Bardreamaster/Chasis/README.md

# Robot Control Board

**Images**
