Bardreamaster/Chasis/Codes/img/003_vscode_open_folder.png

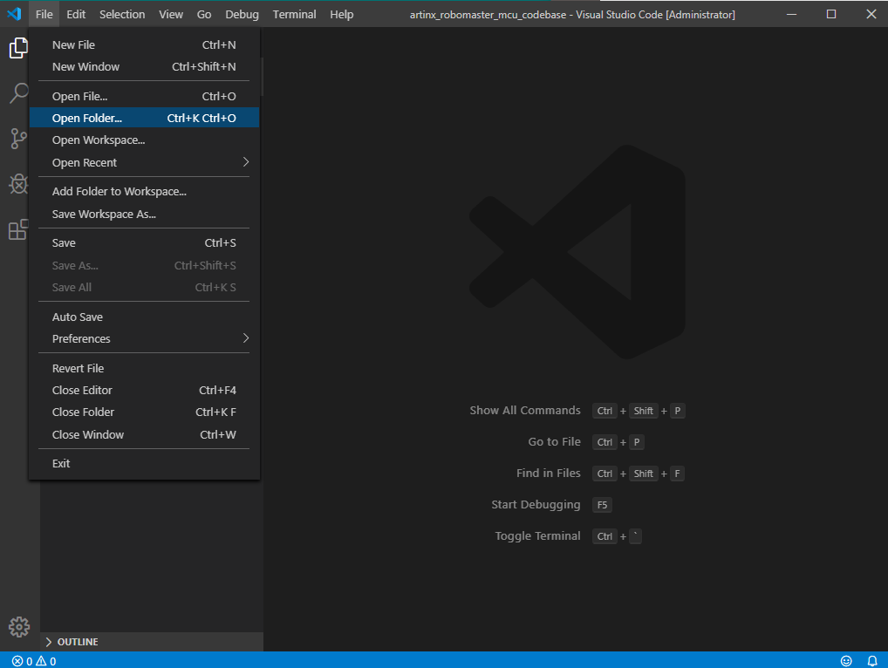
Codes/img/003_vscode_open_folder.png
