Bardreamaster/Chasis/Codes/img/004_vscode_open_folder_2.png

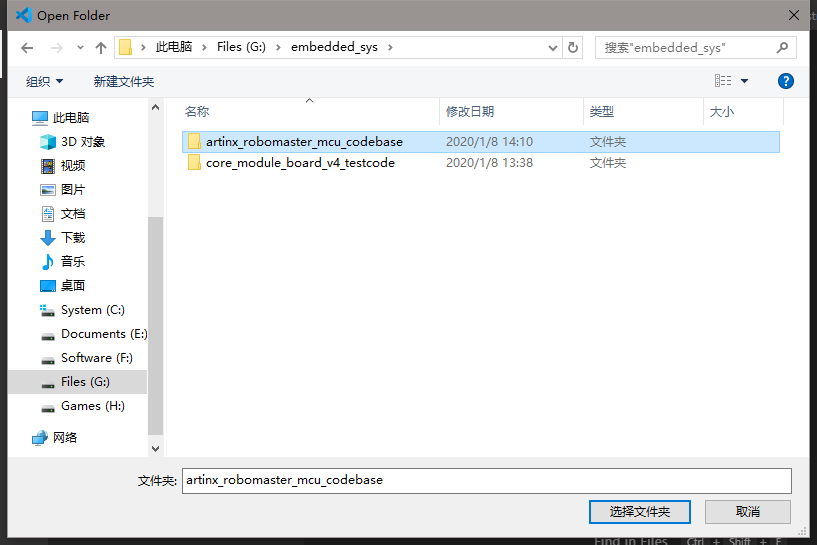
Codes/img/004_vscode_open_folder_2.png
