Bardreamaster/Chasis/Codes/img/013_clone_path.png

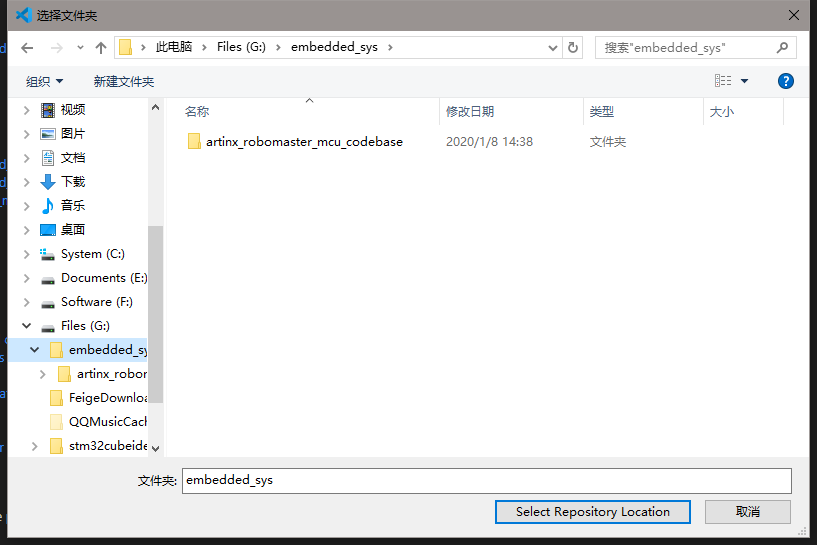
Codes/img/013_clone_path.png
