Bardreamaster/Chasis/Codes/img/015_includepath.png

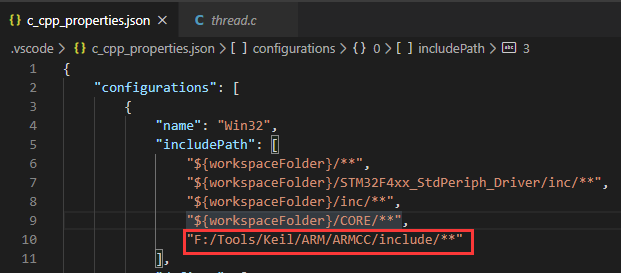
Codes/img/015_includepath.png
