Bardreamaster/Chasis/Schematic/CUT/Chasis1.2B1.png

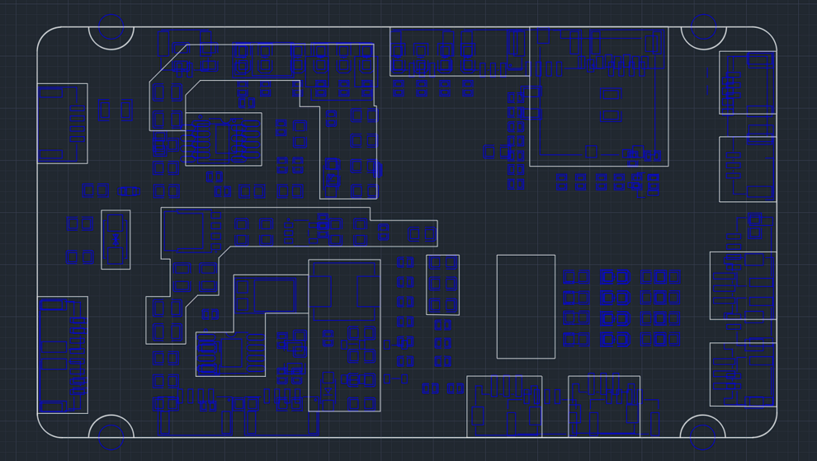
Schematic/CUT/Chasis1.2B1.png
