Bardreamaster/Chasis/Schematic/CUT/Chasis1.2B2.png

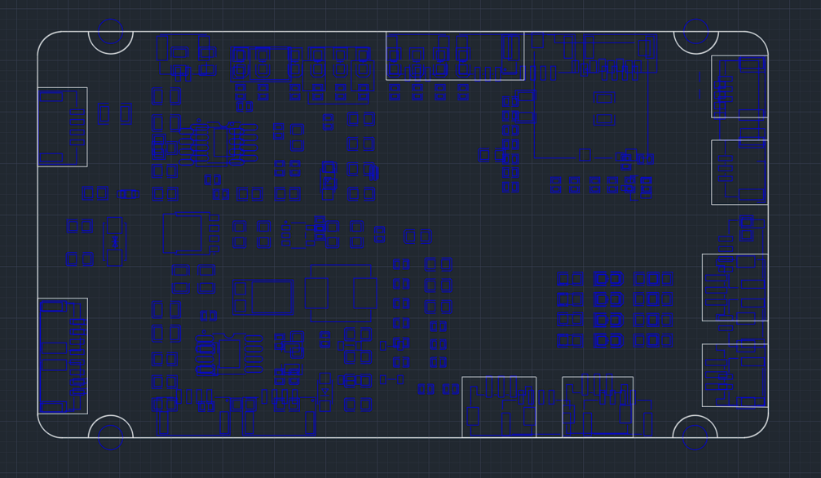
Schematic/CUT/Chasis1.2B2.png
