Bardreamaster/Chasis/Schematic/CUT/Chasis1.2T1.png

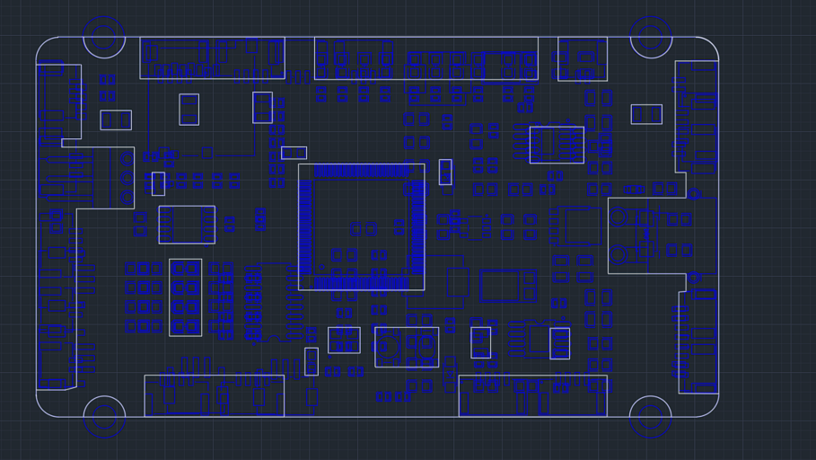
Schematic/CUT/Chasis1.2T1.png
