Bardreamaster/Chasis/Schematic/CUT/Chasis1.2T2.png

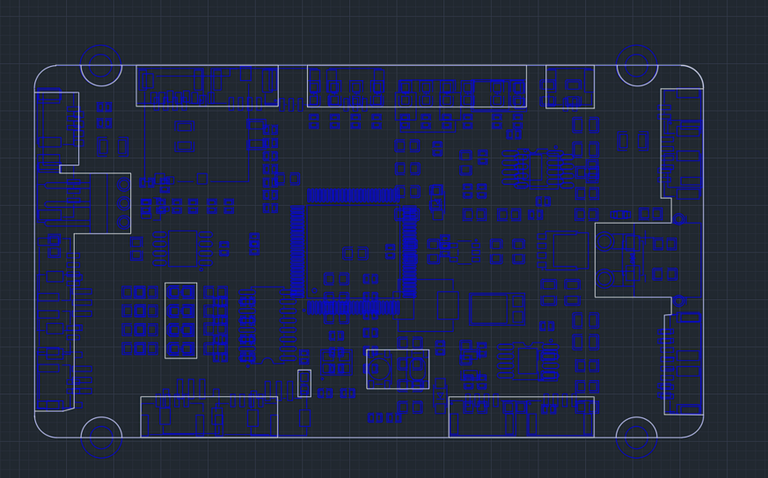
Schematic/CUT/Chasis1.2T2.png
