Bardreamaster/Chasis/Schematic/BOM_Chasis1.21_2020-05-11_00-41-37.csv

ID | Name | Designator | Footprint | Quantity | Manufacturer Part | Manufacturer | Supplier | Supplier Part | LCSC Assembly
1 | 22 | R66,R63,R67,R61,R57,R60 | R0402 | 6 | 0402WGF220JTCE | UniOhm | LCSC | C25092 | Yes
2 | SKRPADE010 | SW2 | KEY-SMD_4P-L4.2-W3.2-P2.20-LS4.6 | 1 | SKRPADE010 | ALPS | LCSC | C127488
3 | MF-NSMF050-2 | U9,U8,U2,U12,U7,U11 | FUSE-1206 | 6 | MF-NSMF050-2 | BOURNS | LCSC | C75464 | Yes
4 | 10uF | C12 | C0603 | 1 | CL10A106KP8NNNC | SAMSUNG | LCSC | C19702 | Yes
5 | 100 | R9,R16 | R0402 | 2 | AC0402FR-07100RL | YAGEO | LCSC | C144808
6 | molexP4卧 | CN1 | SMD-10.15X4.8-4P | 1 | 532610471 | MOLEX | LCSC | C127368
7 | 100k | R22 | R0603 | 1
8 | 33R | R23 | R0603 | 1
9 | X1251WVS-02HF-LPSW | CN11,CN12 | CONN-SMD_2P-V-P1.25-L_X1251WVS-02HF-LPSW | 2 | X1251WVS-02HF-LPSW | XKB Enterprise | LCSC | C388714
10 | 10K | R50,R49,R48,R69,R6,R3,R4,R2,R1,R65,R59,R55,R53,R52,R51 | R0402 | 15 | 0402WGF1002TCE | UniOhm | LCSC | C25744 | Yes
11 | 40.2K | R8,R15 | R0603 | 2 | 0603WAF4022T5E | UniOhm | LCSC | C12447 | Yes
12 | 4.7nF | C43,C30 | C0402 | 2 | 0402B472K500NT | FH | LCSC | C1538 | Yes
13 | X1251WRS-08HF-LPSW | CN26 | CONN-SMD_8P-H-P1.25-L_X1251WRS-08HF-LPSW | 1 | X1251WRS-08HF-LPSW | XKB Enterprise | LCSC | C388713
14 | 120 | R24,R32 | R0603 | 2 | CR0402FF1200G | LIZ | LCSC | C100218
15 | 68K | R13,R14,R20,R21 | R0603 | 4 | 0603WAF6802T5E | UniOhm | LCSC | C23231 | Yes
16 | PSMN1R5-30YLC,115 | Q1 | SOT-669_L4.9-W4.0-P1.27-LS6.0-BR | 1 | PSMN1R5-30YLC,115 | Nexperia | LCSC | C427523
17 | 18pF | C13,C14 | C0201 | 2 | GRM0335C1H180JA01D | MuRata | LCSC | C85892
18 | ORH-G36G | LED2,LED4,LED1,LED3,LED6,LED7,LED8,LED9,LED11,LED5 | LED0603-R-RD | 10 | ORH-G36G | Orient | LCSC | C205443 | Yes
19 | 100pF | C37,C24 | C0603 | 2 | CGA3E2C0G1H101JT0Y0N | TDK | LCSC | C76709
20 | 2.2uF | C15,C16 | C0603 | 2 | CL10A225KO8NNNC | SAMSUNG | LCSC | C23630 | Yes
21 | 12MHz | X1 | OSC-SMD_4P-L3.2-W2.5-BL | 1 | SMD-3225_4P12M12pf10ppm | TAE | LCSC | C133337 | Yes
22 | LP5907MFX-2.5/NOPB | U5 | SOT-23-5_L3.0-W1.7-P0.95-LS2.8-BL | 1 | LP5907MFX-2.5/NOPB | TI | LCSC | C165132 | Yes
23 | 6.8uH | L3,L2 | IND-SMD_L7.0-W6.6 | 2 | FXL0630-6R8-M | cjiang | LCSC | C167221
24 | SMAJ26CA-13-F | D5 | SMA_L4.4-W2.6-LS5.0-BI | 1 | SMAJ26CA-13-F | DIODES | LCSC | C134976 | Yes
25 | 10nf | C44 | C0603 | 1
26 | 19-217/R6C-AL1M2VY/3T | LED14,LED12,LED15,LED13,LED10 | LED0603-R-RD | 5 | 19-217/R6C-AL1M2VY/3T | EVERLIGHT | LCSC | C72044 | Yes
27 | 4.7K | R35,R37 | R0402 | 2 | RC-02W4701FT | Guangdong Fenghua Advanced Tech | LCSC | C304616
28 | 1K | R26,R28,R36,R38,R34,R33,R31,R30,R29,R68,R64,R27,R58,R54,R25 | R0402 | 15 | 0402WGF1001TCE | UniOhm | LCSC | C11702 | Yes
29 | BZX584C9V1 | D6 | SOD-523F_L1.7-W0.9-LS1.7-RD | 1 |  |  | LCSC |  | Yes
30 | MCP2562-E/SN | U6,U10 | SOP-8_150MIL | 2 | MCP2562-E/SN | MICROCHIP | LCSC | C53609
31 | A1257WR-S-3P | CN24,CN25,CN23,CN21 | CONN-SMD_A1257WR-S-3P | 4 | A1257WR-S-3P | Changjiang Connectors | LCSC | C225126
32 | A1257WR-S-2P | CN4,CN9,CN5,CN8,CN2 | CONN-SMD_A1257WR-S-2P | 5 | A1257WR-S-2P | Changjiang Connectors | LCSC | C225125
33 | KF2510-3AGW | DBUS1 | KF2510-3AGW-2.54MM | 1 | KF2510-3AGW | BOOMELE | LCSC | C68663
34 | 100pF | C11 | C0402 | 1 | 0402CG101J500NT | FH | LCSC | C1546 | Yes
35 | BZT52C5V1_C173407 | D3,D1 | SOD-123_L2.7-W1.6-LS3.7-RD | 2 | BZT52C5V1 | (MDD) Jiangsu Yutai Elec | LCSC | C173407 | Yes
36 | X1251WRS-04HF-LPSW | CN10,CN7,CN3,CN13,CN17 | CONN-TH_4PIN-H-MALE-PITCH1.25-L_X1251WRS-04HF-LPSW | 5 | X1251WRS-04HF-LPSW | XKB Enterprise | LCSC | C388709
37 | SVM860VB_R2_00001 | D2,D4 | TO-277B_3P-L6.1-W4.3-LS7.0-BR | 2 | SVM860VB_R2_00001 | PANJIT International | LCSC | C391734
38 | 100nF | C19,C32,C53 | C0402 | 3 | AC0603KRX7R0BB104 | YAGEO | LCSC | C408909
39 | 1uF | C2,C3 | C0603 | 2 | CL10A105KB8NNNC | SAMSUNG | LCSC | C15849 | Yes
40 | TLP291-4(GB-TP,E(T | U13 | SOP-16_L10.3-W4.4-P1.27-LS7.0-BL | 1 | TLP291-4(GB-TP,E(T | TOSHIBA | LCSC | C60900 | Yes
41 | 473521001 | CARD1 | MICRO-SD-SOCKET-PP-DETECT | 1 | 473521001 | MOLEX | LCSC | C293569
42 | 47pF | C42,C29 | C0402 | 2 | 0402CG470J500NT | FH | LCSC | C1567 | Yes
43 | 120Ω | L1 | L0603 | 1 | MPZ1608S121ATAH0 | TDK | LCSC | C114770
44 | 22uF | C23,C34,C33,C20,C21,C49,C48,C46,C45,C22,C36,C35 | C0603 | 12 | CL10A226MQ8NRNC | SAMSUNG | LCSC | C59461 | Yes
45 | 120 | R7,R5 | R0402 | 2 | 0402WGF1200TCE | UniOhm | LCSC | C25079 | Yes
46 | A1501WR-S-3P | CN22,CN20,CN18,CN19 | CONN-SMD_A1501WR-S-3P | 4 | A1501WR-S-3P | Changjiang Connectors | LCSC | C225168
47 | 100nF | C1,C50,C10,C17,C9,C6,C4,C5,C18,C31,C7,C51,C8 | C0402 | 13 | CL05B104KO5NNNC | SAMSUNG | LCSC | C1525 | Yes
48 | PMBT3904,215 | Q2 | SOT-23_L2.9-W1.3-P0.95-LS2.4-BR | 1 | PMBT3904,215 | Nexperia | LCSC | C8667 | Yes
49 | 309K | R17,R10 | R0603 | 2 | 0603WAF3093T5E | UniOhm | LCSC | C23001 | Yes
50 | XT30PW-M | XT1 | XT30PW | 1 | XT60
51 | SKRPABE010 | SW1 | KEY-SMD-4P_L4.2-W3.2-H2.5 | 1 | SKRPABE010 | ALPS | LCSC | C115360
52 | 7.68K | R18,R11 | R0402 | 2 | 0402WGF7681TCE | UniOhm | LCSC | C25919 | Yes
53 | 100nF | C47 | C0402 | 1 | GRM188R71H104KA93D | MuRata | LCSC | C77055
54 | 17.8K | R12,R19 | R0603 | 2 | 0603WAF1782T5E | UniOhm | LCSC | C22821 | Yes
55 | TPS54540DDAR | U3,U4 | SOIC-8_L4.9-W3.9-P1.27-LS6.0-BL-EP | 2 | TPS54540DDAR | TI | LCSC | C95286 | Yes
56 | X1251WVS-04HF-LPSW | CN16,CN15,CN14 | CONN-SMD_4P-V-P1.25-L_X1251WVS-04HF-LPSW | 3 | X1251WVS-04HF-LPSW | XKB Enterprise | LCSC | C388716
57 | 4.7uF | C28,C26,C25,C41,C40,C39,C38,C27 | C0805 | 8 | CL21A475KBQNNNE | SAMSUNG | LCSC | C98192
58 | 0 | R43,R42,R70,R71,R62,R46,R45,R44,R47,R75,R74,R73,R72,R76,R77,R56 | R0603 | 16 | 0603WAJ0000T5E | UniOhm | LCSC | C15402
59 | 1 | R39 | R0603 | 1 | 0603WAF100KT5E | UniOhm | LCSC | C22936 | Yes
60 | STM32F405VGT6 | U1 | LQFP-100_L14.0-W14.0-P0.50-LS16.0-TL | 1 | STM32F405VGT6 | ST | LCSC | C56621
