Bardreamaster/Chasis/Schematic/Chasis1.21_2020-07-29_16-37-17.dxf

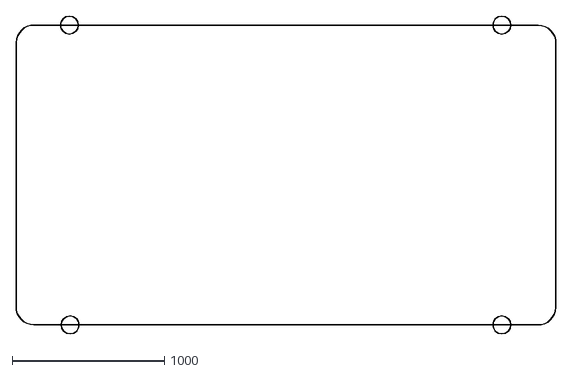
[picture p25: CAD file, 2021-09-17]
Schematic/Chasis1.21_2020-07-29_16-37-17.dxf
3546.3 x 2088.1
