Bardreamaster/Chasis/Schematic/CUT/Chasis1.2B1.51.dxf

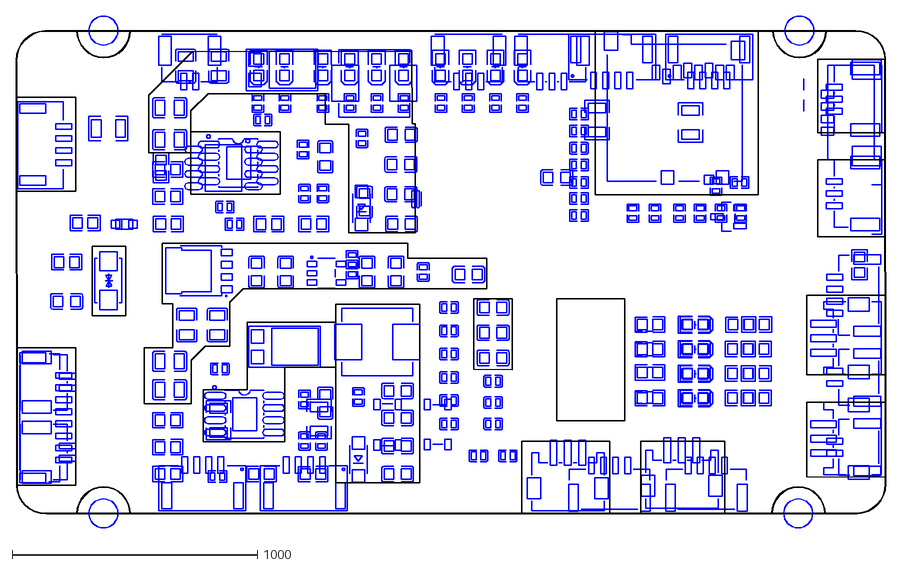
[picture p26: CAD file, 2021-09-17]
Schematic/CUT/Chasis1.2B1.51.dxf
3547.6 x 2088.1
