Bardreamaster/Chasis/Schematic/CUT/Chasis1.2B1.5.dxf

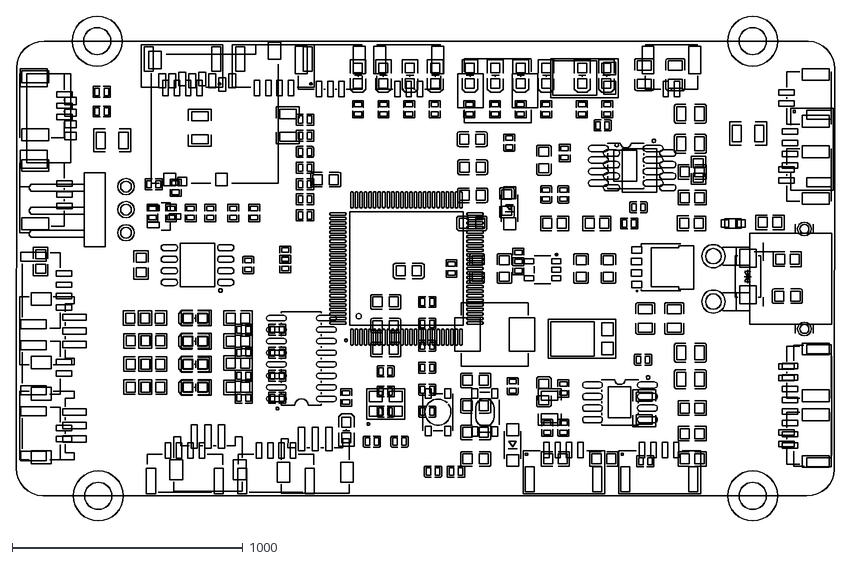
[picture p27: CAD file, 2021-09-17]
Schematic/CUT/Chasis1.2B1.5.dxf
3546.3 x 2186.5
