Bardreamaster/Chasis/(list of files, cad)

Other CAD files:
Schematic/CUT/Chasis1.2B1.dwg
Schematic/CUT/Chasis1.2T1.dwg
