Bardreamaster/Chasis/DeveloperGuide/引脚定义.jpg

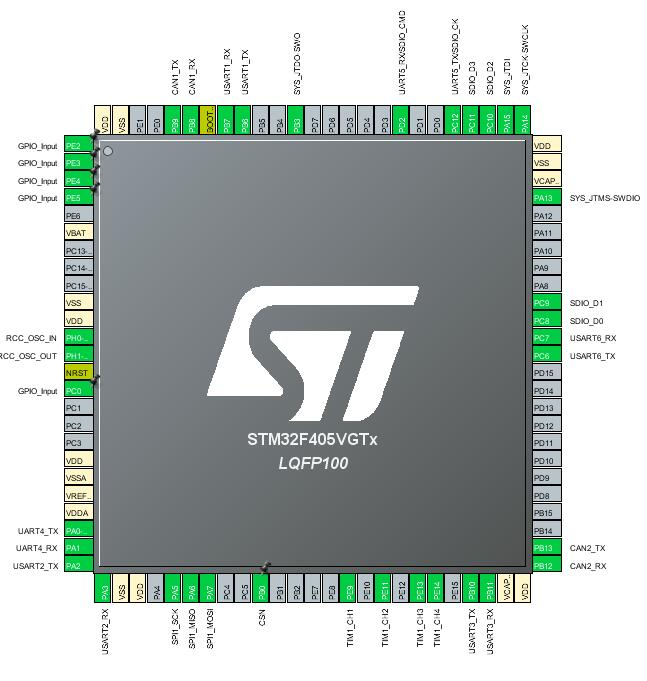
DeveloperGuide/引脚定义.jpg
