Bardreamaster/Chasis/Schematic/Schematic_Chasis1.2.pdf

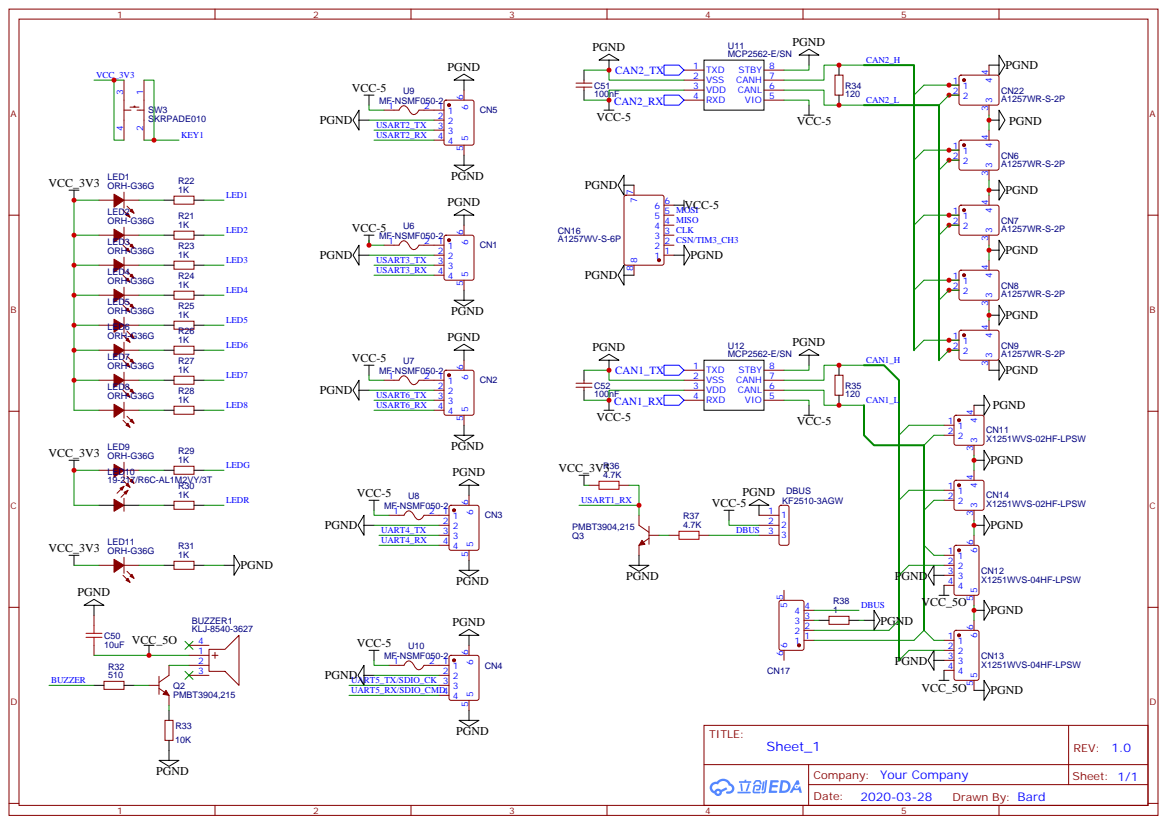
[picture p29: page 1]

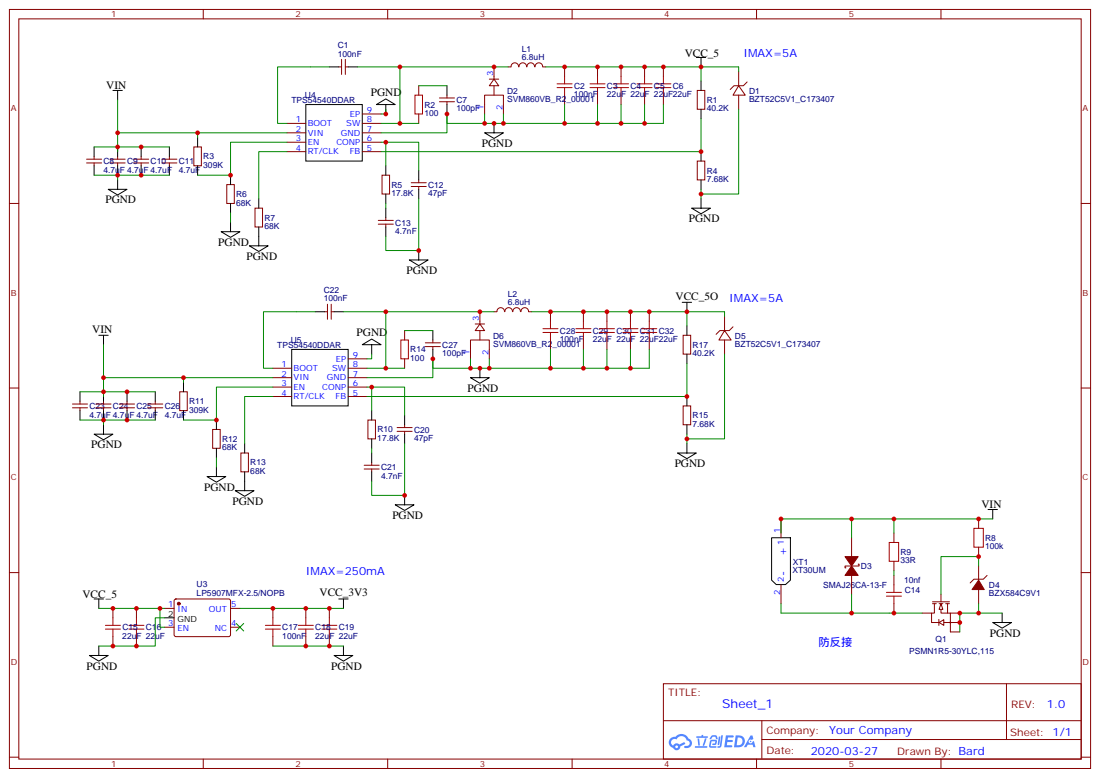
[picture p30: page 2]

# GND GND GND GND

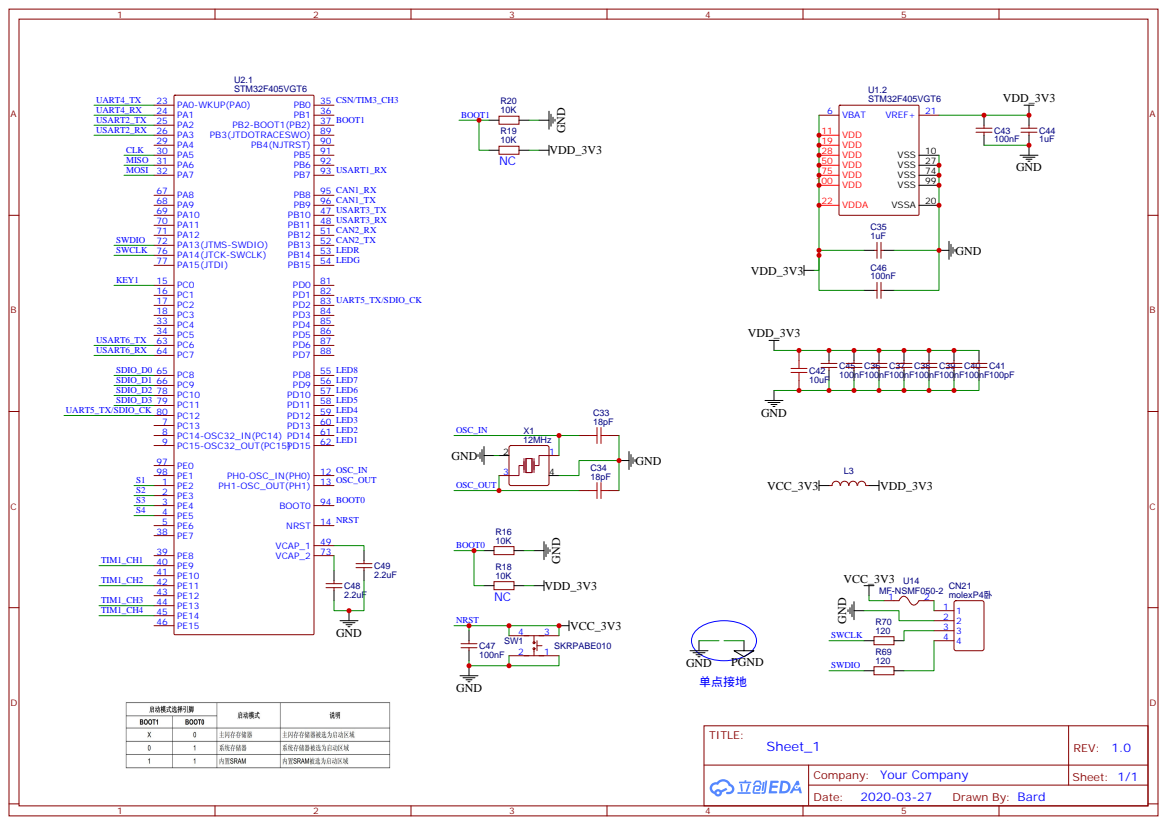
[picture p31: page 3]

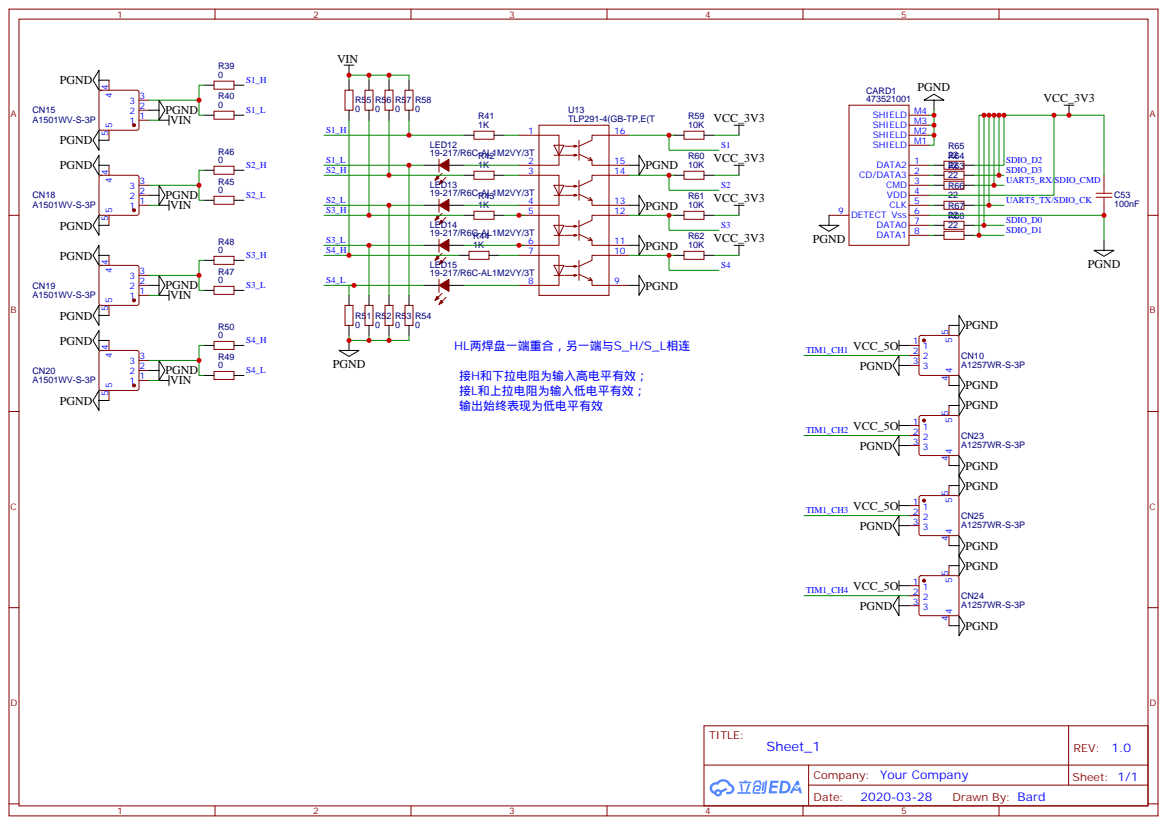
[picture p32: page 4]
