Bardreamaster/Chasis/DeveloperGuide/Chasis.ioc

Mcu.UserName=STM32F405VGTx
PA0-WKUP.Signal=UART4_TX
PA1.Signal=UART4_RX
PA10.Signal=S_TIM1_CH3
PA11.Signal=S_TIM1_CH4
PA13.Signal=SYS_JTMS-SWDIO
PA14.Signal=SYS_JTCK-SWCLK
PA15.Signal=SYS_JTDI
PA2.Signal=USART2_TX
PA3.Signal=USART2_RX
PA5.Signal=SPI1_SCK
PA6.Signal=SPI1_MISO
PA7.Signal=SPI1_MOSI
PA8.Signal=S_TIM1_CH1
PA9.Signal=S_TIM1_CH2
PB0.Signal=S_TIM3_CH3
PB1.Signal=S_TIM3_CH4
PB10.Signal=USART3_TX
PB11.Signal=USART3_RX
PB12.Signal=CAN2_RX
PB13.Signal=CAN2_TX
PB3.Signal=SYS_JTDO-SWO
PB6.Signal=USART1_TX
PB7.Signal=USART1_RX
PB8.Signal=CAN1_RX
PB9.Signal=CAN1_TX
PC0.Signal=GPIO_Input
PC10.Signal=SDIO_D2
PC11.Signal=SDIO_D3
PC12.GPIO_Label=UART5_TX/SDIO_CK
PC12.Signal=SDIO_CK
PC6.Signal=USART6_TX
PC7.Signal=USART6_RX
PC8.Signal=SDIO_D0
PC9.Signal=SDIO_D1
PD2.GPIO_Label=UART5_RX/SDIO_CMD
PD2.Signal=SDIO_CMD
PE2.Signal=GPIO_Input
PE3.Signal=GPIO_Input
PE4.Signal=GPIO_Input
PE5.Signal=GPIO_Input
PE7.Signal=S_TIM1_ETR
PH0-OSC_IN.Signal=RCC_OSC_IN
PH1-OSC_OUT.Signal=RCC_OSC_OUT
