Bardreamaster/Chasis/Codes/rt_thread/board.c

/*
 * Copyright (c) 2006-2019, RT-Thread Development Team
 *
 * SPDX-License-Identifier: Apache-2.0
 *
 * Change Logs:
 * Date           Author       Notes
 * 2017-07-24     Tanek        the first version
 * 2018-11-12     Ernest Chen  modify copyright
 */

//#include "board.h"

#include <stdint.h>
#include <rthw.h>
#include <rtthread.h>
#include "stm32f4xx.h"

#define _SCB_BASE       (0xE000E010UL)
#define _SYSTICK_CTRL   (*(rt_uint32_t *)(_SCB_BASE + 0x0))
#define _SYSTICK_LOAD   (*(rt_uint32_t *)(_SCB_BASE + 0x4))
#define _SYSTICK_VAL    (*(rt_uint32_t *)(_SCB_BASE + 0x8))
#define _SYSTICK_CALIB  (*(rt_uint32_t *)(_SCB_BASE + 0xC))
#define _SYSTICK_PRI    (*(rt_uint8_t  *)(0xE000ED23UL))

// Updates the variable SystemCoreClock and must be called 
// whenever the core clock is changed during program execution.
extern void SystemCoreClockUpdate(void);

// Holds the system core clock, which is the system clock 
// frequency supplied to the SysTick timer and the processor 
// core clock.
extern uint32_t SystemCoreClock;

static int uart_init(void)
{
    USART_InitTypeDef USART_InitStruct;
    GPIO_InitTypeDef GPIO_InitStruct;
    
    RCC_APB1PeriphClockCmd(RCC_APB1Periph_USART2, ENABLE);
    RCC_AHB1PeriphClockCmd(RCC_AHB1Periph_GPIOA, ENABLE);    
    GPIO_PinAFConfig(GPIOA, GPIO_PinSource2, GPIO_AF_USART2);
    GPIO_PinAFConfig(GPIOA, GPIO_PinSource3, GPIO_AF_USART2);
    GPIO_InitStruct.GPIO_Pin   = GPIO_Pin_2|GPIO_Pin_3;
    GPIO_InitStruct.GPIO_Mode  = GPIO_Mode_AF;
    GPIO_InitStruct.GPIO_Speed = GPIO_Speed_50MHz;
    GPIO_InitStruct.GPIO_OType = GPIO_OType_PP;
    GPIO_InitStruct.GPIO_PuPd  = GPIO_PuPd_UP;
    GPIO_Init(GPIOA, &GPIO_InitStruct);
    
    USART_InitStruct.USART_BaudRate            = 115200;
    USART_InitStruct.USART_WordLength          = USART_WordLength_8b;
    USART_InitStruct.USART_StopBits            = USART_StopBits_1;
    USART_InitStruct.USART_Parity              = USART_Parity_No;
    USART_InitStruct.USART_HardwareFlowControl = USART_HardwareFlowControl_None;
    USART_InitStruct.USART_Mode                = USART_Mode_Rx|USART_Mode_Tx;
    USART_Init(USART2, &USART_InitStruct);
    
    USART_Cmd(USART2, ENABLE);

    return 0;
}

char rt_hw_console_getchar(void)
{
    int ch = -1;
    if(USART_GetFlagStatus(USART2,USART_FLAG_RXNE) != RESET){
        ch = USART2->DR & 0xff;
    }
    else{
        if(USART_GetFlagStatus(USART2,USART_FLAG_ORE) != RESET){
            USART_ClearFlag(USART2, USART_FLAG_ORE);
        }
        rt_thread_mdelay(10);
    }
    return ch;
}

static uint32_t _SysTick_Config(rt_uint32_t ticks)
{
    if ((ticks - 1) > 0xFFFFFF)
    {
        return 1;
    }
    
    _SYSTICK_LOAD = ticks - 1; 
    _SYSTICK_PRI = 0xFF;
    _SYSTICK_VAL  = 0;
    _SYSTICK_CTRL = 0x07;  
    
    return 0;
}

#if defined(RT_USING_USER_MAIN) && defined(RT_USING_HEAP)
#define RT_HEAP_SIZE 1024
static uint32_t rt_heap[RT_HEAP_SIZE];     // heap default size: 4K(1024 * 4)
RT_WEAK void *rt_heap_begin_get(void)
{
    return rt_heap;
}

RT_WEAK void *rt_heap_end_get(void)
{
    return rt_heap + RT_HEAP_SIZE;
}
#endif



/**
 * This function will initial your board.
 */
void rt_hw_board_init()
{
    /* System Clock Update */
    SystemCoreClockUpdate();
    
    /* System Tick Configuration */
    _SysTick_Config(SystemCoreClock / RT_TICK_PER_SECOND);
    
    /* FinSH UART initialization */    
    uart_init();

    /* Call components board initial (use INIT_BOARD_EXPORT()) */
#ifdef RT_USING_COMPONENTS_INIT
    rt_components_board_init();
#endif

#if defined(RT_USING_USER_MAIN) && defined(RT_USING_HEAP)
    rt_system_heap_init(rt_heap_begin_get(), rt_heap_end_get());
#endif
    
    
}

void SysTick_Handler(void)
{
    /* enter interrupt */
    rt_interrupt_enter();

    rt_tick_increase();

    /* leave interrupt */
    rt_interrupt_leave();
}
