Bardreamaster/Chasis/Codes/src/test/can_list.h

#ifndef CAN_LIST_H
#define CAN_LIST_H

#ifdef __cplusplus
extern "C" {
#endif
	//made time: Sun Jan 12 00:06:13 2020
#include "stdint.h"
	static uint16_t channel_high_speed_0[10] = { 0x121 , 0x141 , 0x121 , 0x152 , 0x121 , 0x0 , 0x121 , 0x0 , 0x121 , 0x0 };

	static uint16_t channel_high_speed_1[10] = { 0x131 , 0x142 , 0x131 , 0x32 , 0x131 , 0x0 , 0x131 , 0x0 , 0x131 , 0x0 };

	static uint16_t channel_high_speed_2[10] = { 0x132 , 0x151 , 0x132 , 0x0 , 0x132 , 0x0 , 0x132 , 0x0 , 0x132 , 0x0 };

	static uint16_t channel_low_speed_0[100] = { 0x31 ,0x0 ,0x0 ,0x0 ,0x0 ,0x0 ,0x0 ,0x0 ,0x0 ,0x0 ,0x0 ,0x0 ,0x0 ,0x0 ,0x0 ,0x0 ,0x0 ,0x0 ,0x0 ,0x0 ,0x31 ,0x0 ,0x0 ,0x0 ,0x0 ,0x0 ,0x0 ,0x0 ,0x0 ,0x0 ,0x0 ,0x0 ,0x0 ,0x0 ,0x0 ,0x0 ,0x0 ,0x0 ,0x0 ,0x0 ,0x31 ,0x0 ,0x0 ,0x0 ,0x0 ,0x0 ,0x0 ,0x0 ,0x0 ,0x0 ,0x0 ,0x0 ,0x0 ,0x0 ,0x0 ,0x0 ,0x0 ,0x0 ,0x0 ,0x0 ,0x31 ,0x0 ,0x0 ,0x0 ,0x0 ,0x0 ,0x0 ,0x0 ,0x0 ,0x0 ,0x0 ,0x0 ,0x0 ,0x0 ,0x0 ,0x0 ,0x0 ,0x0 ,0x0 ,0x0 ,0x31 ,0x0 ,0x0 ,0x0 ,0x0 ,0x0 ,0x0 ,0x0 ,0x0 ,0x0 ,0x0 ,0x0 ,0x0 ,0x0 ,0x0 ,0x0 ,0x0 ,0x0 ,0x0 ,0x0 };

	typedef struct {
		uint16_t can_id;
		uint8_t length;
		uint8_t data[8];
	}can_tx_message_t;

	/*
static can_tx_message_t superC_on_time_power;
static can_tx_message_t imu0_attitude_angle;
static can_tx_message_t imu1_attitude_angle;
static can_tx_message_t imu0_angular_speed;
static can_tx_message_t imu1_angular speed;
static can_tx_message_t imu0_accelerated_speed;
static can_tx_message_t imu2_accelerated_speed;
static can_tx_message_t _17MM_info;
static can_tx_message_t chassis_superC_control;

	superC_on_time_power.can_id = 0x121;
	superC_on_time_power.length = 8;
	imu0_attitude_angle.can_id = 0x131;
	imu0_attitude_angle.length = 8;
	imu1_attitude_angle.can_id = 0x132;
	imu1_attitude_angle.length = 8;
	imu0_angular_speed.can_id = 0x141;
	imu0_angular_speed.length = 8;
	imu1_angular speed.can_id = 0x142;
	imu1_angular speed.length = 8;
	imu0_accelerated_speed.can_id = 0x151;
	imu0_accelerated_speed.length = 8;
	imu2_accelerated_speed.can_id = 0x152;
	imu2_accelerated_speed.length = 8;
	_17MM_info.can_id = 0x31;
	_17MM_info.length = 8;
	chassis_superC_control.can_id = 0x32;
	chassis_superC_control.length = 8;
	*/
#ifdef __cplusplus
}
#endif

#endif
