Bardreamaster/Chasis/Codes/src/test/music.h

#ifndef MUSIC_H
#define MUSIC_H

#include "stm32f4xx.h"

#ifdef __cplusplus
 extern "C" {
#endif /* __cplusplus */

void buzzer_music(void);
void buzzer_init(void);

#ifdef __cplusplus
}
#endif /* __cplusplus */

#endif /* MUSIC_H */
